mhanuel26/Wiznet-PoE-Rudge-PLC-Hardware/IMG_20220429_184617.jpg

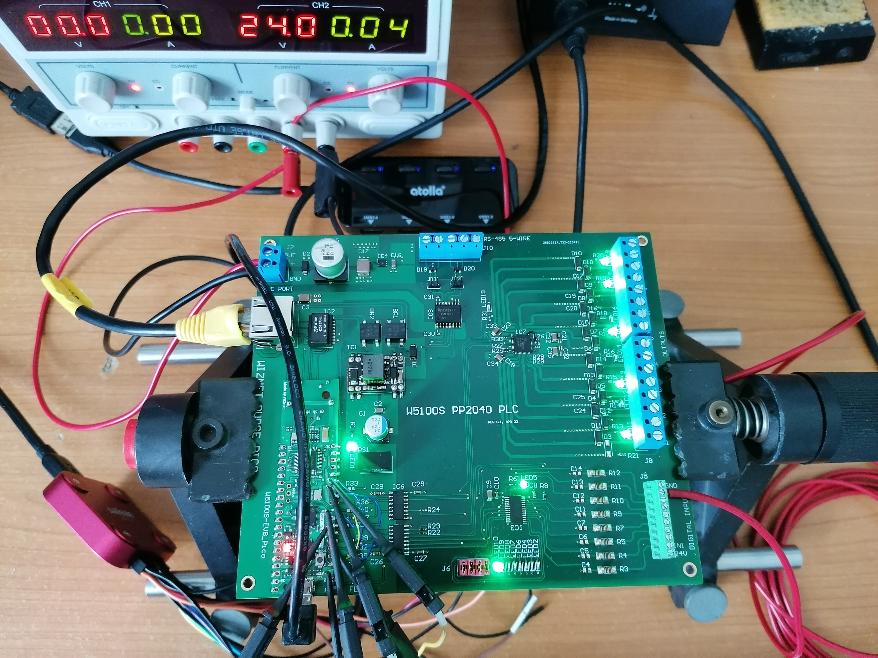
IMG_20220429_184617.jpg
