mhanuel26/Wiznet-PoE-Rudge-PLC-Hardware/README.md

# Wiznet-PoE-Rudge-PLC-Hardware
Schematic and gerber files for the Wiznet PoE Rudge Industrial PLC.
