mhanuel26/Wiznet-PoE-Rudge-PLC-Hardware/SPI_Bus.md

The MAX14900 device and MAX31912 uses SPI1 module on the W5100S-EVB-Pico board as the W5100S uses SPI0. Here are some traces of the SPI module 1 
lines when polling the device from OpenPLC software. 
The captures are made when using the Arduino firmware  https://github.com/mhanuel26/Wiznet-PoE-Rudge-PLC-Firmware
and the OpenPLC implementation https://www.openplcproject.com/

Figure 1 shows the two SPI transactions, first is for comms with MAX14900 (using chip select signal O_CS), second is MAX31912 (using chip select signal I_CS)
readout_spi_plc_1

Figure 2 shows consecutive readings as per the internal loop in Arduino code and the two Ethernet requests.
readout_spi_plc_2

Figure 3 shows the 100ms polling time between SPI bursts, this 100ms time is configured under OpenPLC software as shown in Picture 4. 
readout_spi_plc_3
