mhanuel26/Wiznet-PoE-Rudge-PLC-Hardware/Pico_PLC_Remote_DIN_Rail.STL

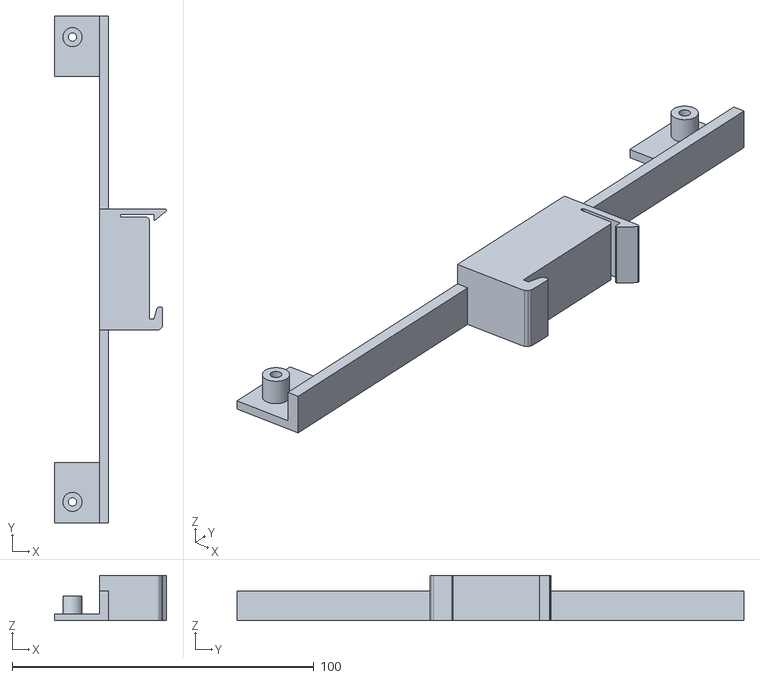
[picture p2: CAD file, 2022-04-29]
Pico_PLC_Remote_DIN_Rail.STL
37.2 x 168.0 x 15.0
