mhanuel26/Wiznet-PoE-Rudge-PLC-Hardware/RP2040_eth_plc.pdf

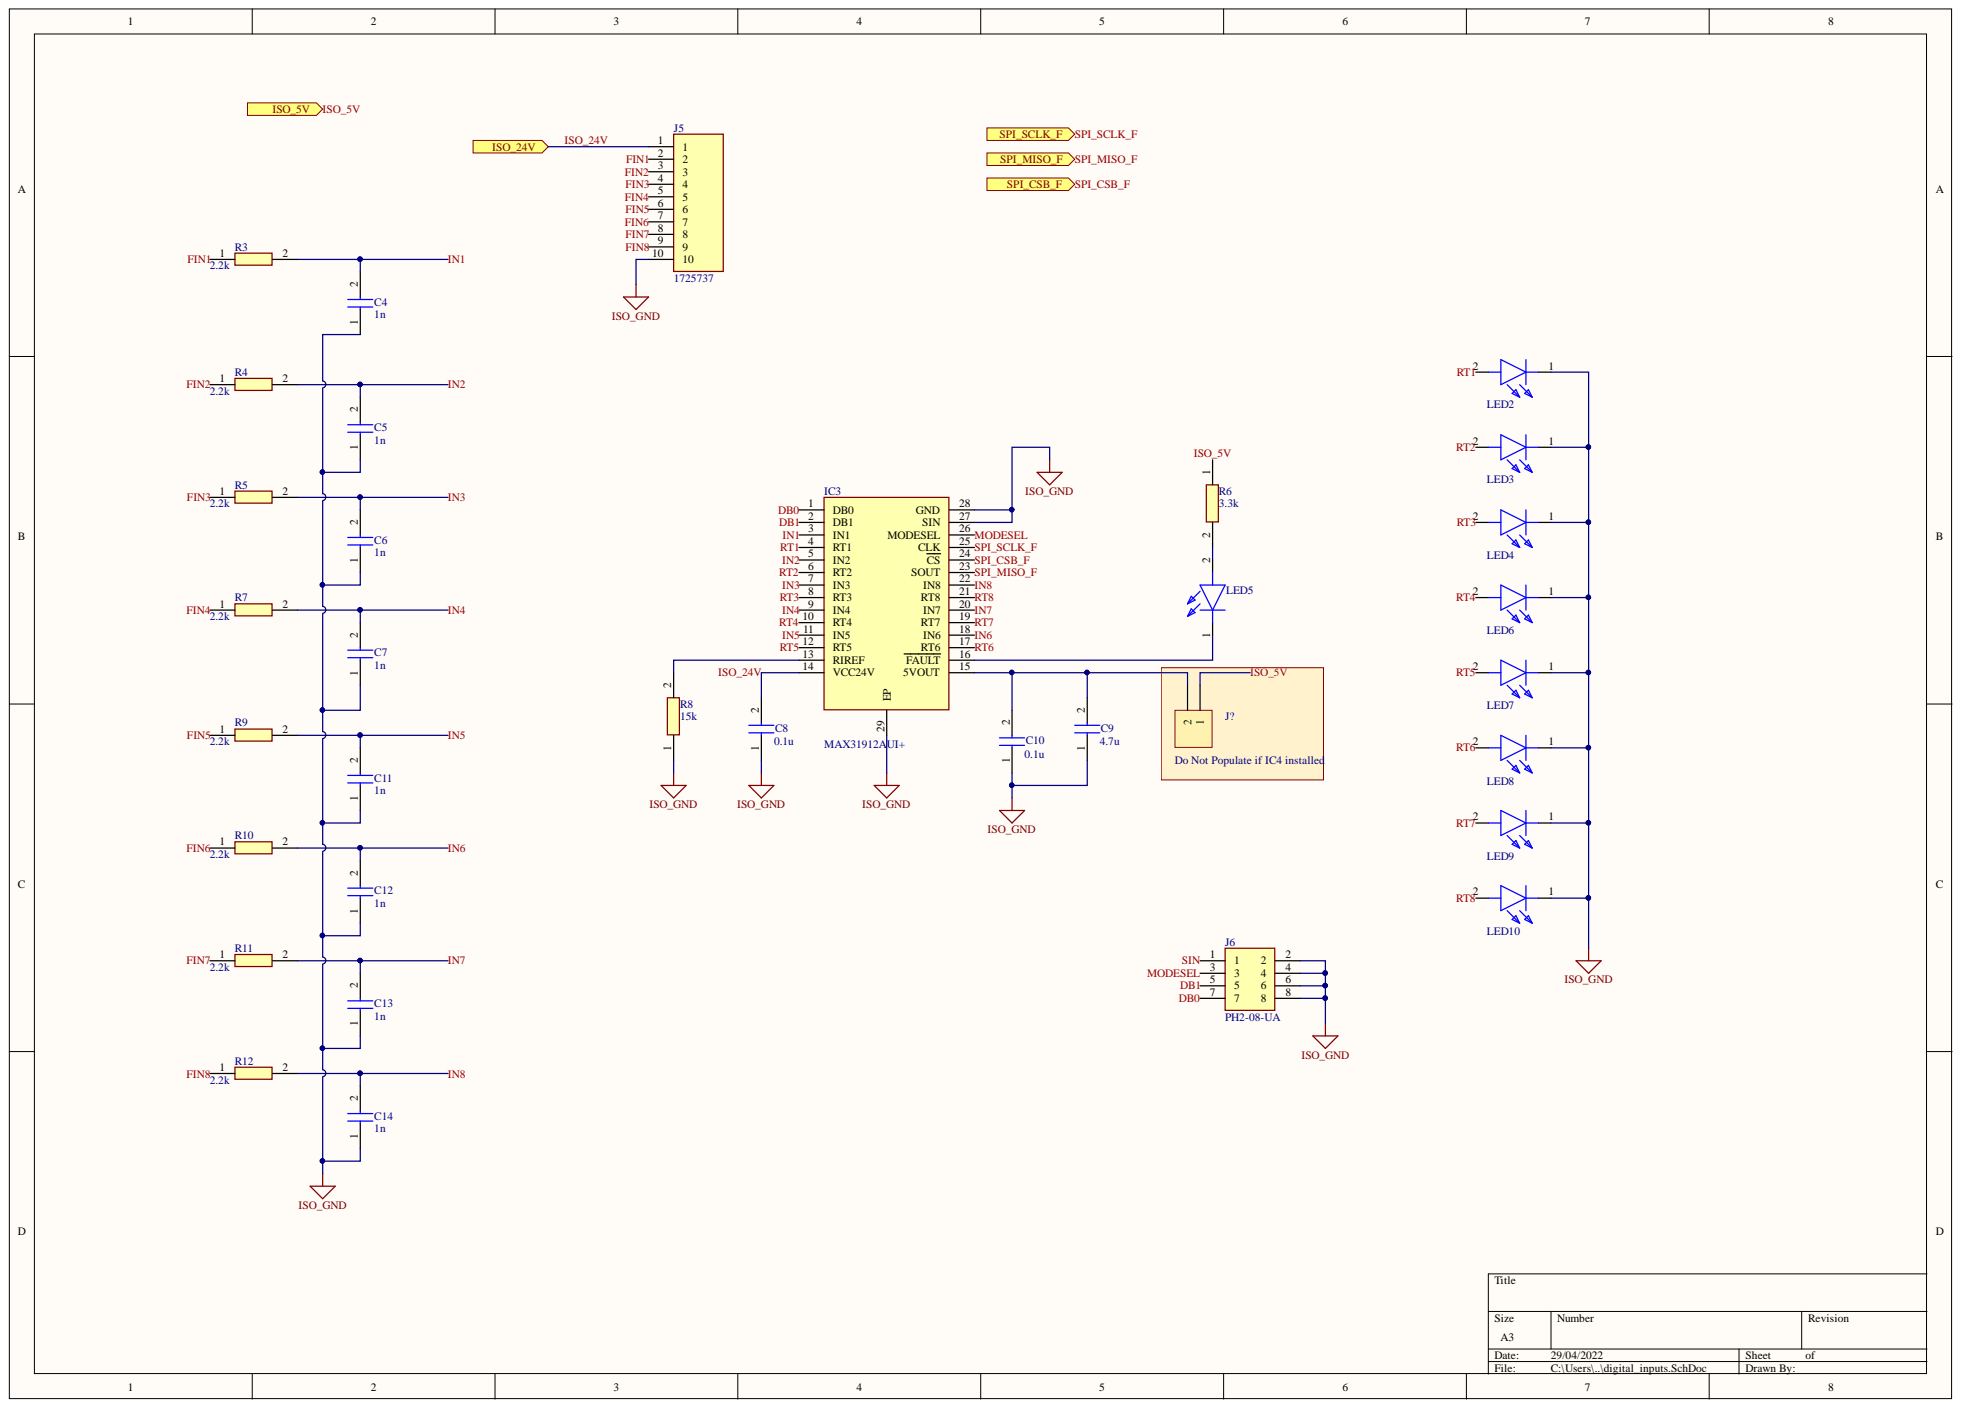
[picture p3: page 1]

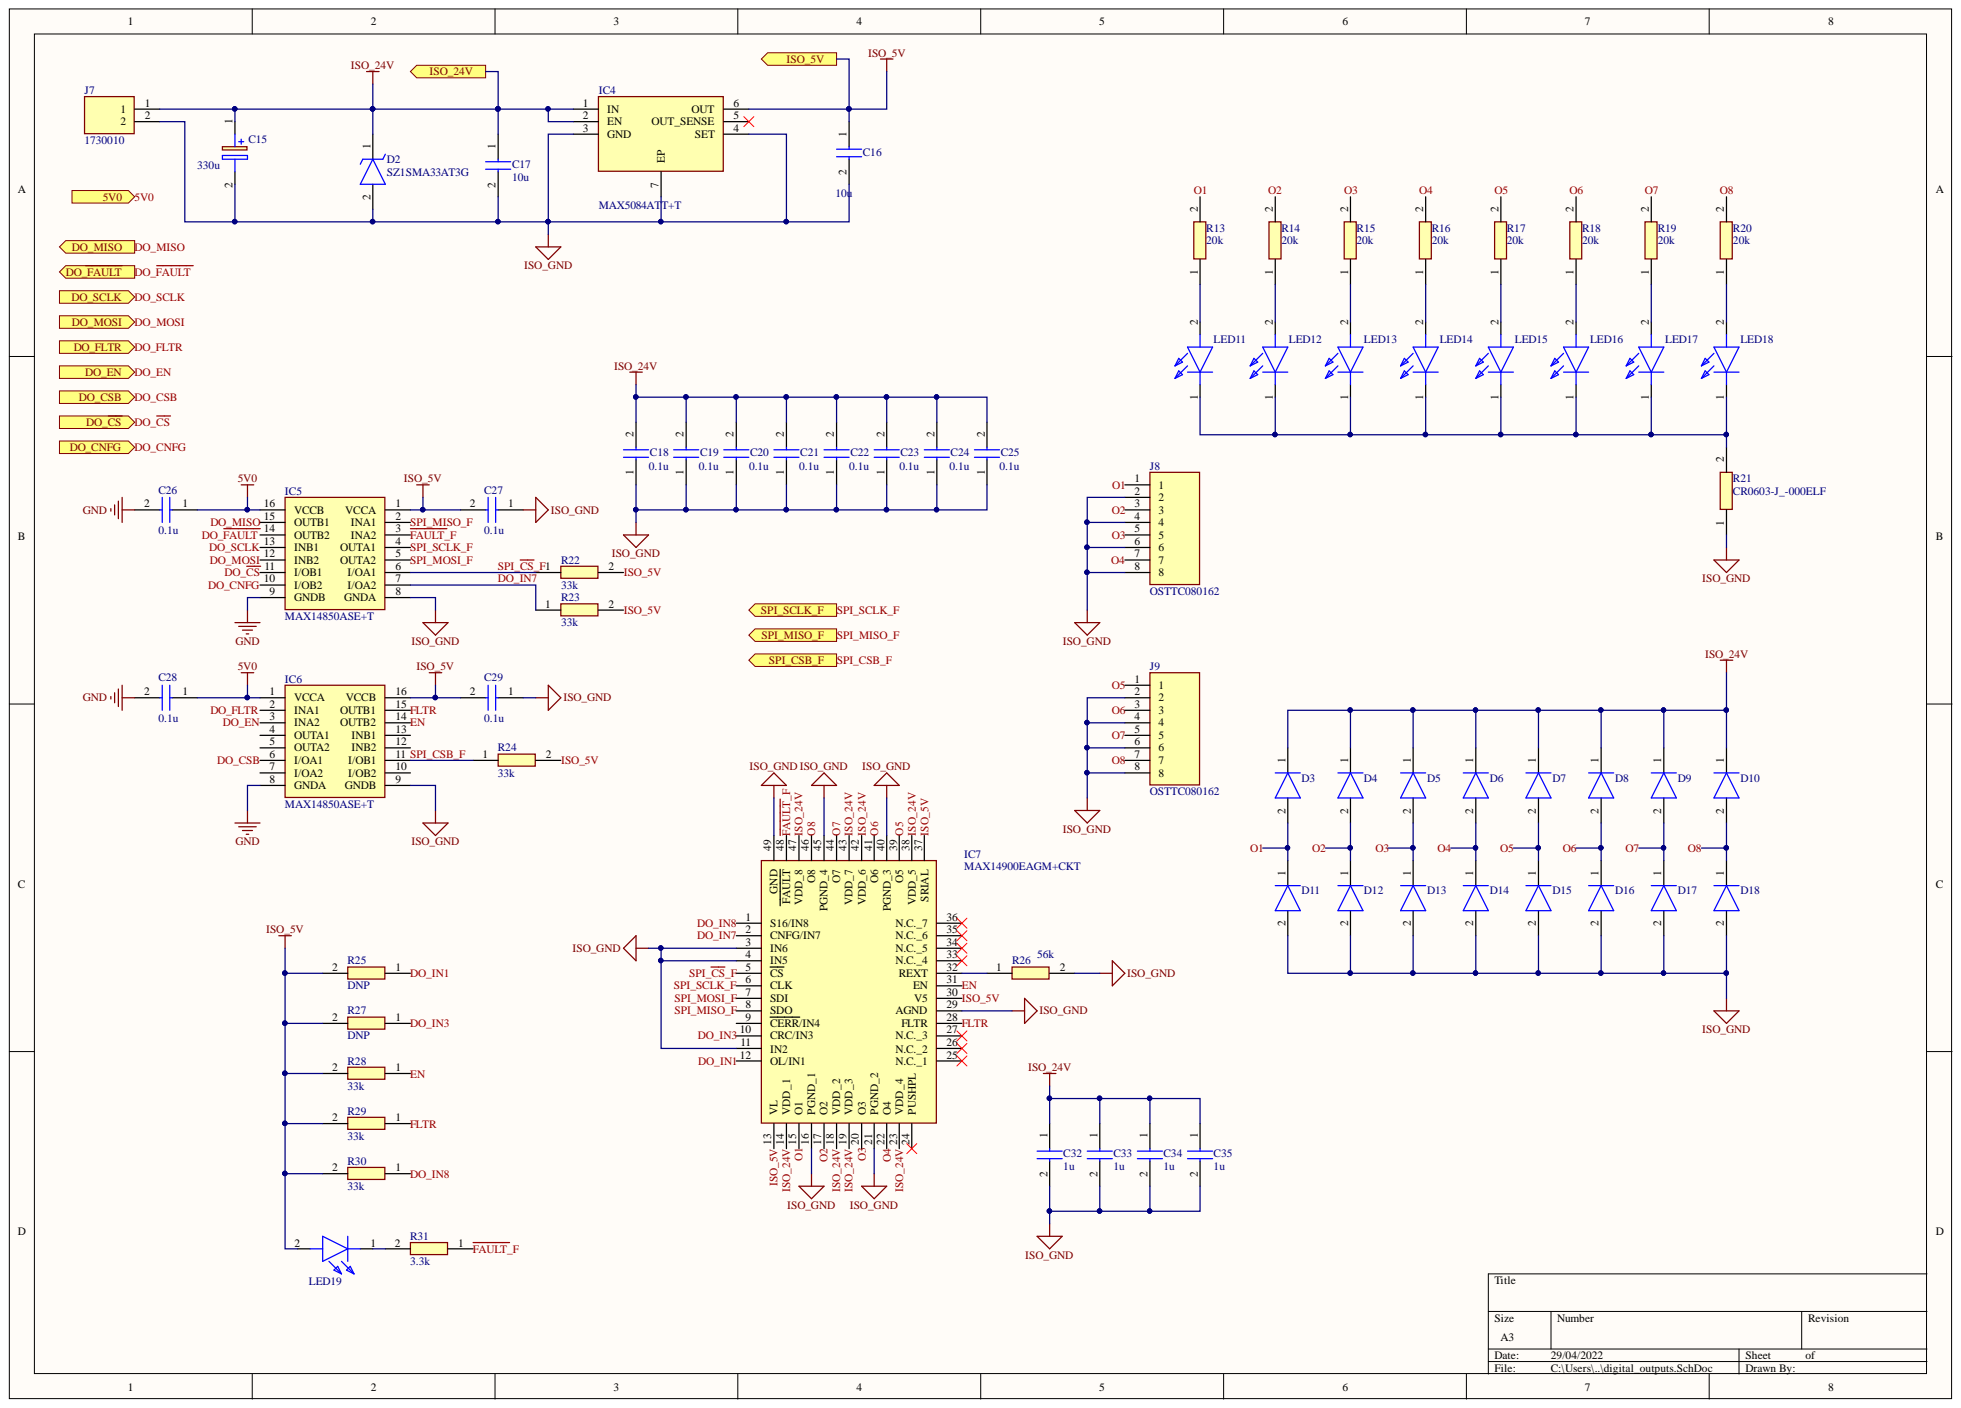
[picture p4: page 2]

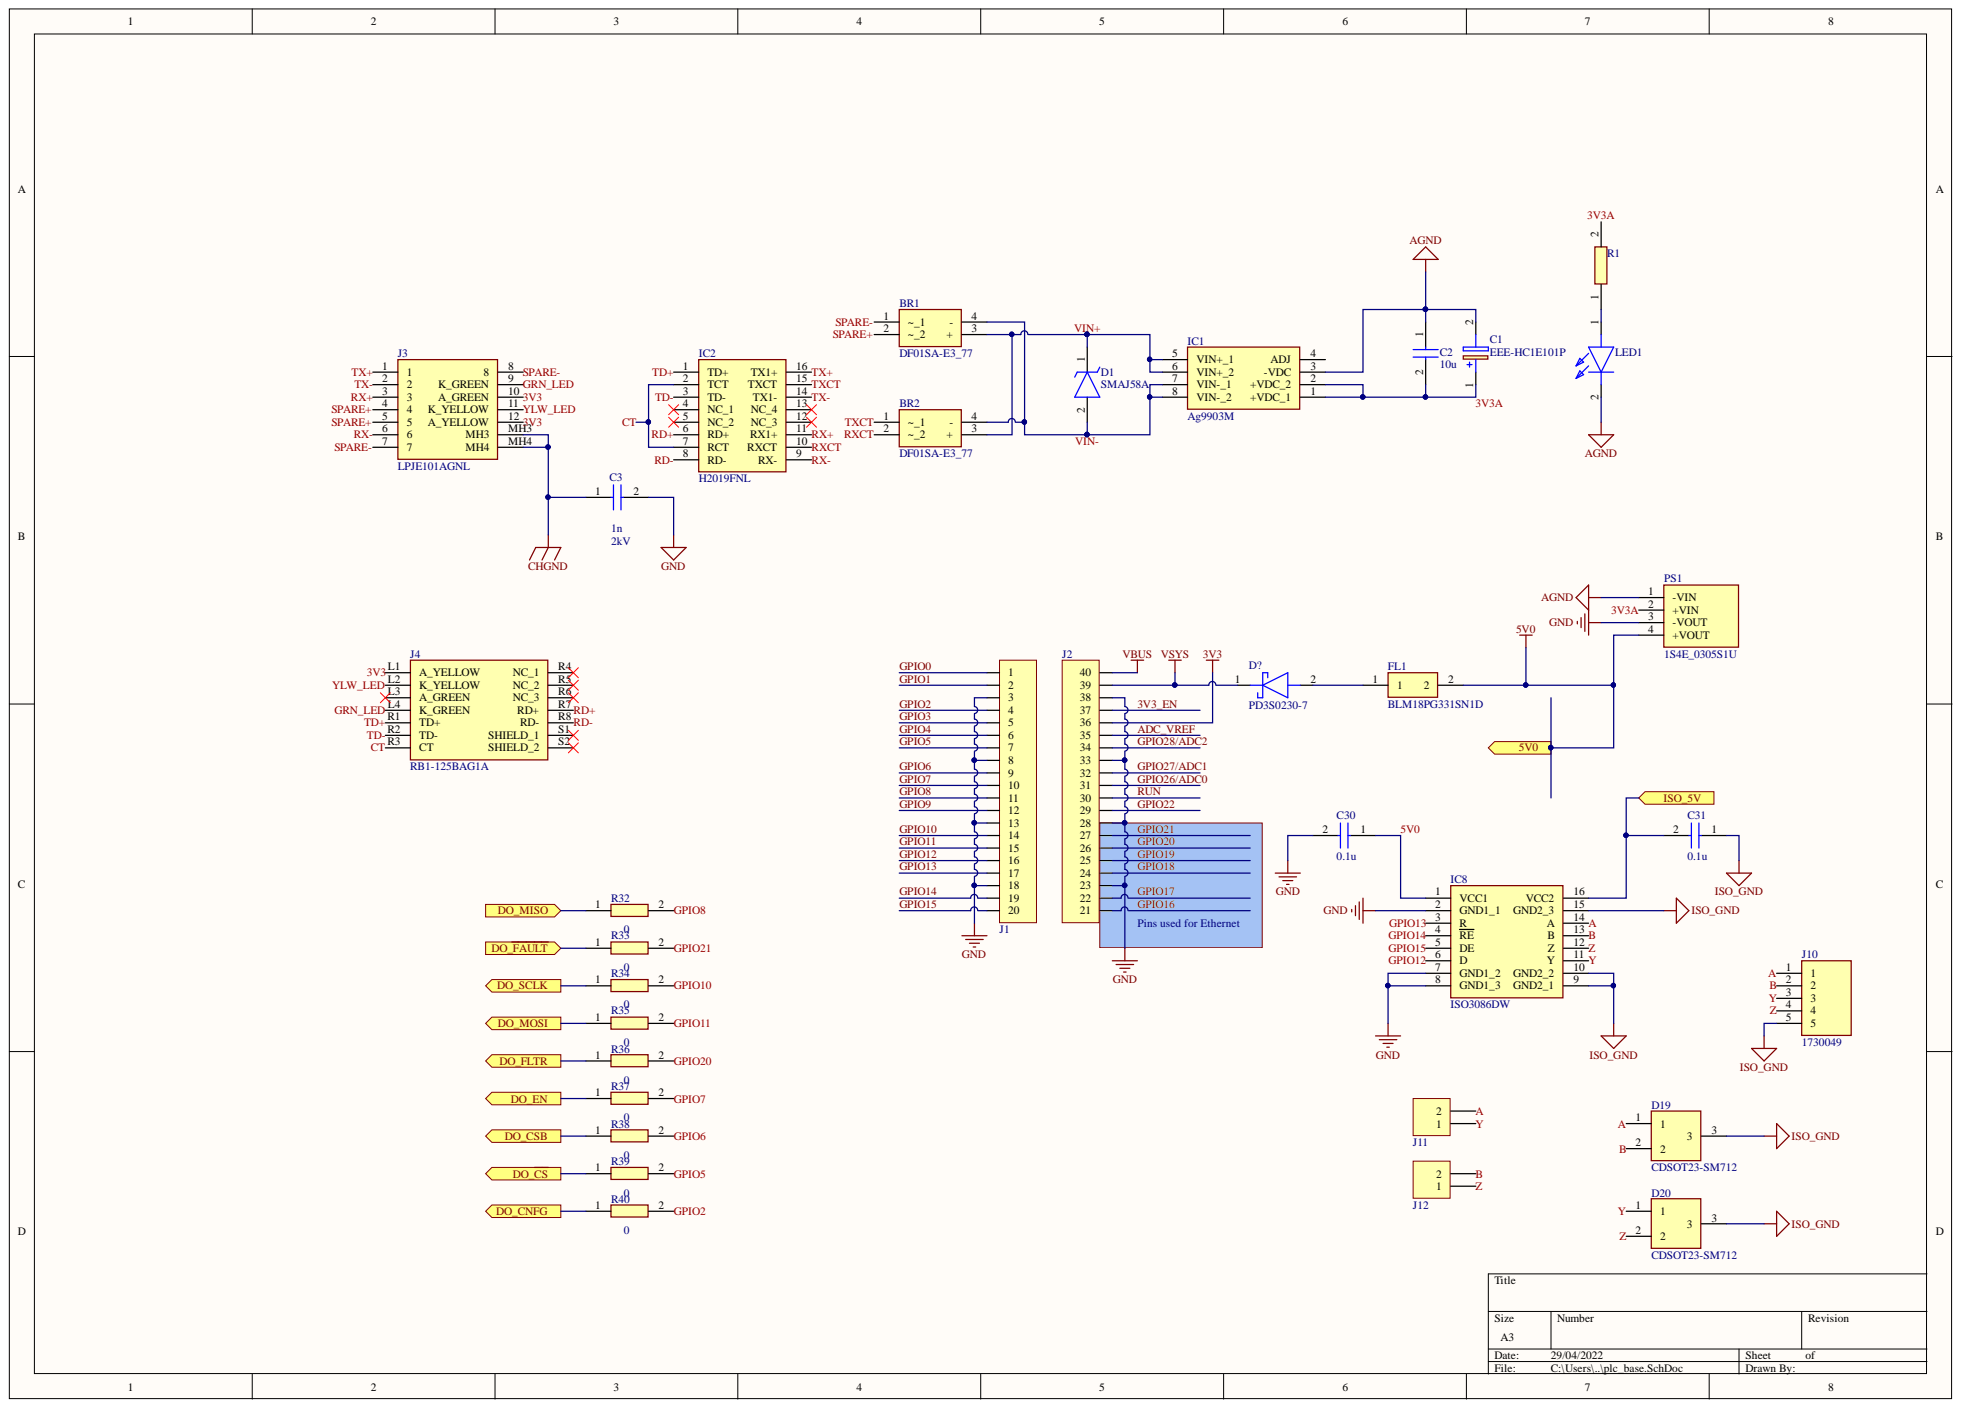
[picture p5: page 3]

Pins used for Ethernet

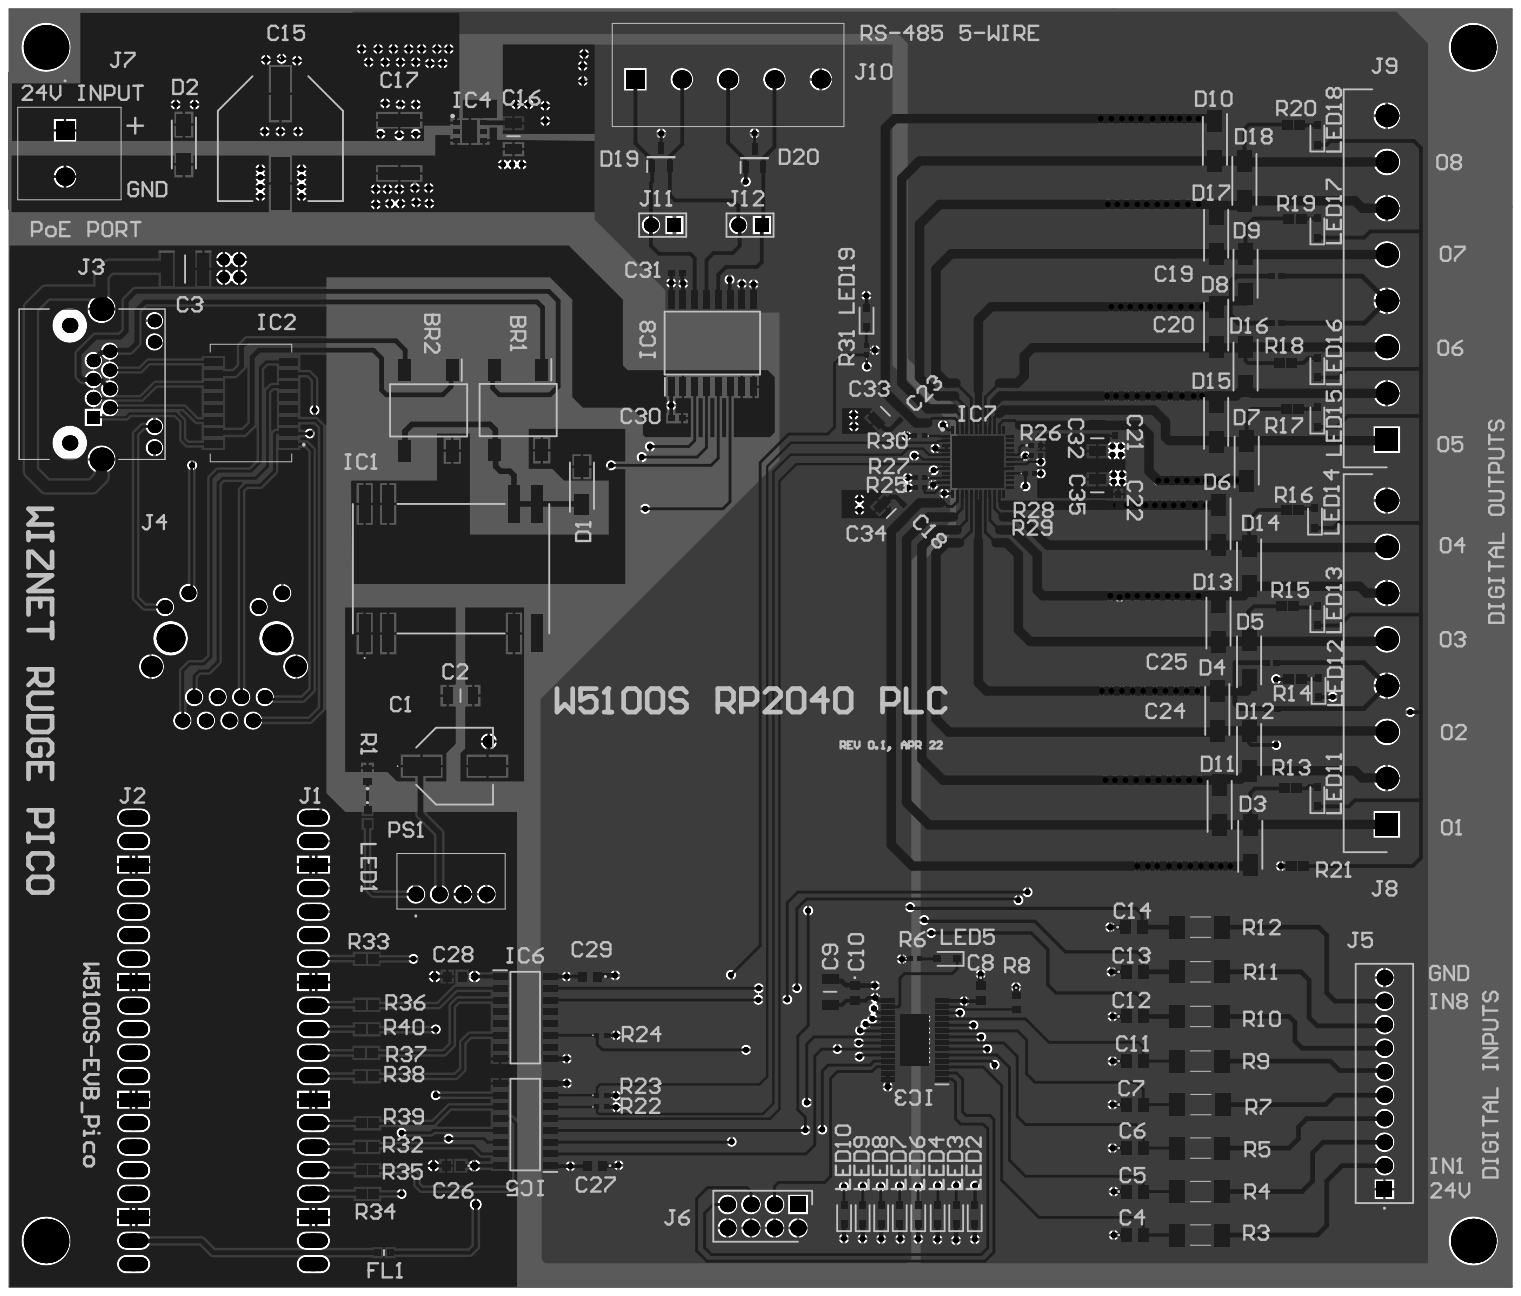
[picture p6: page 4]

Comment | Description | Designator | Footprint | LibRef | Quantity
DF01SA-E3_77 | Bridge Rectifier | BR1, BR2 | SOP510P1005X330-4NDF01SA-E3_77 | 2
EEE-HC1E101P | Capacitor Polarised | C1 | EEE0JA471UAP | EEE-HC1E101P | 1
1206B106K250NT | Capacitor | C2 | CAPC3216X183N | 1206B106K250NT | 1
C1812C102KGRACAUCapacitor | C3 | CAPC4532X155N | C1812C102KGRACAUT | 1
C0805C102KMRECAUCapacitor | C4, C5, C6, C7, C11, CC 0805 | C0805C102KMRECAUT | 8
C0603X104K5RAC331Capacitor | C8, C10, C26, C27, C28, C0603 | C0603X104K5RAC331 | 6
CL31B475KPHNNNE | Capacitor | C9 | CAPC3216X180N | CL31B475KPHNNNE | 1
EEE-FK1H331AQ | Capacitor Polarised | C15 | EEEFK0J332AQ | EEE-FK1H331AQ | 1
C1206C106K8RACTU.Capacitor | C16 | CAPC3216X180N | C1206C106K8RACTU. | 1
C5750X7R1H106M230Capacitor | C17 | C5750_Commercial | C5750X7R1H106M230 | 1
C0603X104K5RAC331Capacitor | C18, C19, C20, C21, CRE SC1005X 55N | C 0603X 104K5RAC331 | 10
C3216X7R1H105K | Capacitor | C32, C33, C34, C35 | CAPC3216X180N | C3216X7R1H105K | 4
SMAJ58A | TVS Diode (Uni-directD1 | DIOM5026X229N | SMAJ58A | 1
SZ1SMA33AT3G | TVS Diode (Uni-directD2 | DIOM5226X220N | SZ1SMA33AT3G | 1
MURA205T3G | Diode | D3, D4, D5, D6, D7, DD IOM5226X 220 N | MURA 205T 3G | 16
CDSOT23-SM712 | Diode | D19, D20 | SOT95P230X117-3N | CDSOT23-SM712 | 2
PD3S0230-7 | Schottky Diode | D? | PD3S02307 | PD3S0230-7 | 1
BLM18PG331SN1D | Filter | FL1 | BLM18AG102BH1D | BLM18PG331SN1D | 1
Ag9903M | IntegratedCircuit | IC1 | Ag9903M | Ag9903M | 1
H2019FNL | IntegratedCircuit | IC2 | H2019FNL | H2019FNL | 1
MAX31912AUI+ | IntegratedCircuit | IC3 | SOP65P638X110-29NMAX31912AUI+ | 1
MAX5084ATT+T | IntegratedCircuit | IC4 | SON95P300X300X80-MA X5084ATT+T | 1
MAX14850ASE+T | IntegratedCircuit | IC5, IC6 | SOIC127P600X175-16MA X14850ASE+T | 2
MAX14900EAGM+CKTIntegratedCircuit | IC7 | QFN50P700X700X90-MA X14900EAGM+CKT | 1
ISO3086DW | IntegratedCircuit | IC8 | SOIC127P1030X265-1ISO3086DW | 1
2.54mm 1x20 Pin Hea2.54mm 1x20 Pin HeaJ1, J 2 | IDC-1X20 | 2.54mm 1x20 Pin Hea | 2
LPJE101AGNL | Connector | J3 | LPJE101AGNL | LPJE101AGNL | 1
RB1-125BAG1A | Connector | J4 | RB1-125BAG1A | RB1-125BAG1A | 1
1725737 | Connector | J5 | 1725737 | 1725737 | 1
PH2-08-UA | Connector | J6 | HDRV8W64P254_2X4_1016X PH2-08-UA | 1
1730010 | Connector | J7 | 1730010 | 1730010 | 1
OSTTC080162 | Connector | J8, J9 | RHDRRA8W100P0X500_1X OSTTC 08 162 | 2
1730049 | Connector | J10 | 1730049 | 1730049 | 1
header 0.1in Two conHeader, 2-Pin | J11, J12, J? | M20-9990246 | Header 2 | 3
HSMY-C197 | LED | LED1 | HSMYC197 | HSMY-C197 | 1
APA2106ZGCK | LED | LED2, LED3, LED4, LELE DC2106X 110 N | APA2106Z GC K | 18
1S4E_0305S1U | Power Supply | PS1 | 1S4E_0303S1U | 1S4E_0305S1U | 1
ERJ-3GEYJ221V | Resistor | R1 | ERJ3EKF1000V | ERJ-3GEYJ221V | 1
MMB02070C2201FB20Re sistor | R3, R4, R5, R7, R9, R10, MMB 02070C 2201FB20MMB 02070C2201FB20 | 8
ERJ-2GEJ332X | Resistor | R6, R31 | ERJ2RKD1004X | ERJ-2GEJ332X | 2
ERJ-PA3F1502V | Resistor | R8 | ERJP03_PA3_(0603) | ERJ-PA3F1502V | 1
RC0603FR-0720KL | Resistor | R13, R14, R15, R16, R17, RESC 1608X 55N | RC0603FR-0720KL | 8
