mhanuel26/Wiznet-PoE-Rudge-PLC-Hardware/(commit log)

2022-04-29 Add files via upload
    Schematic is an updated version (rev 0.2) after some minor hardware fixes (some I/O lines have change). The gerbers are still on rev 0.1.
2022-04-29 Add files via upload
    DIN Rail bracket for the Wiznet PoE Rudge PICO
    [Pico_PLC_Remote_DIN_Rail.STL]
